ayabusa/TI-92-Brainwasher/pcb/README.md

# Custom TI-92 Module PCB
This section of the repo contains the schematic and PCB for the two different boards. You can use the `.zip` files in the gerber directory to order them on different websites.

## Ordering from PCBWay
If you want to support me you can order the PCB directly from PCBWay using these links

### Brainswap module
<a href="https://www.pcbway.com/project/shareproject/TI92_Brainswap_5000_34cc17e4.html">PCB from PCBWay</a>

### Brainwasher board
<a href="https://www.pcbway.com/project/shareproject/W1168534AS5D1_TI92_hat_a221fa38.html">PCB from PCBWay</a>

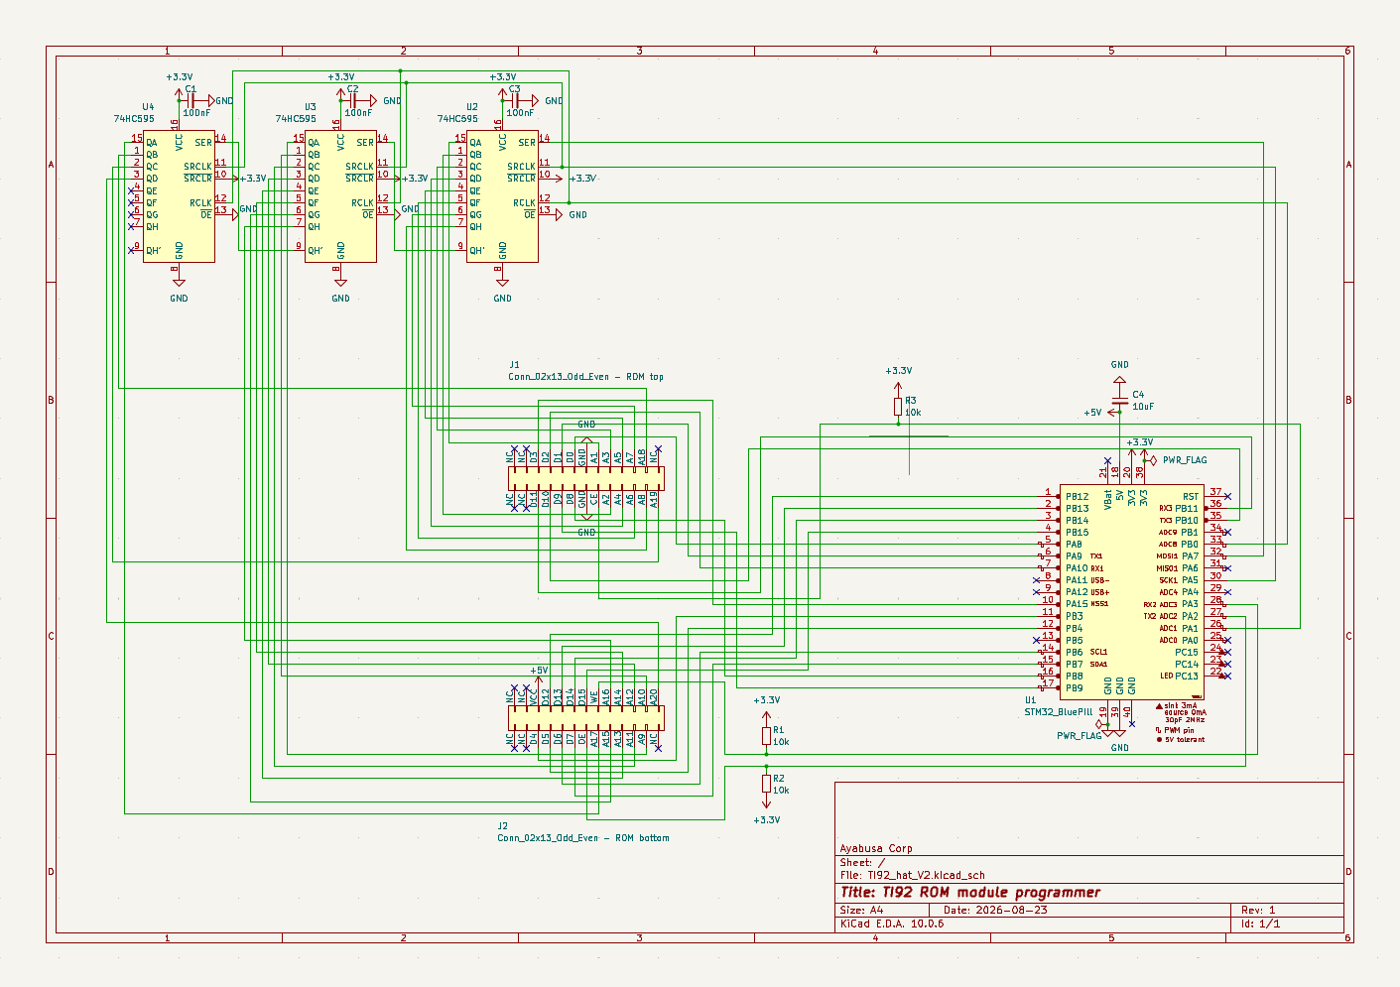
[picture p6: pcb/schema.png]
schematic

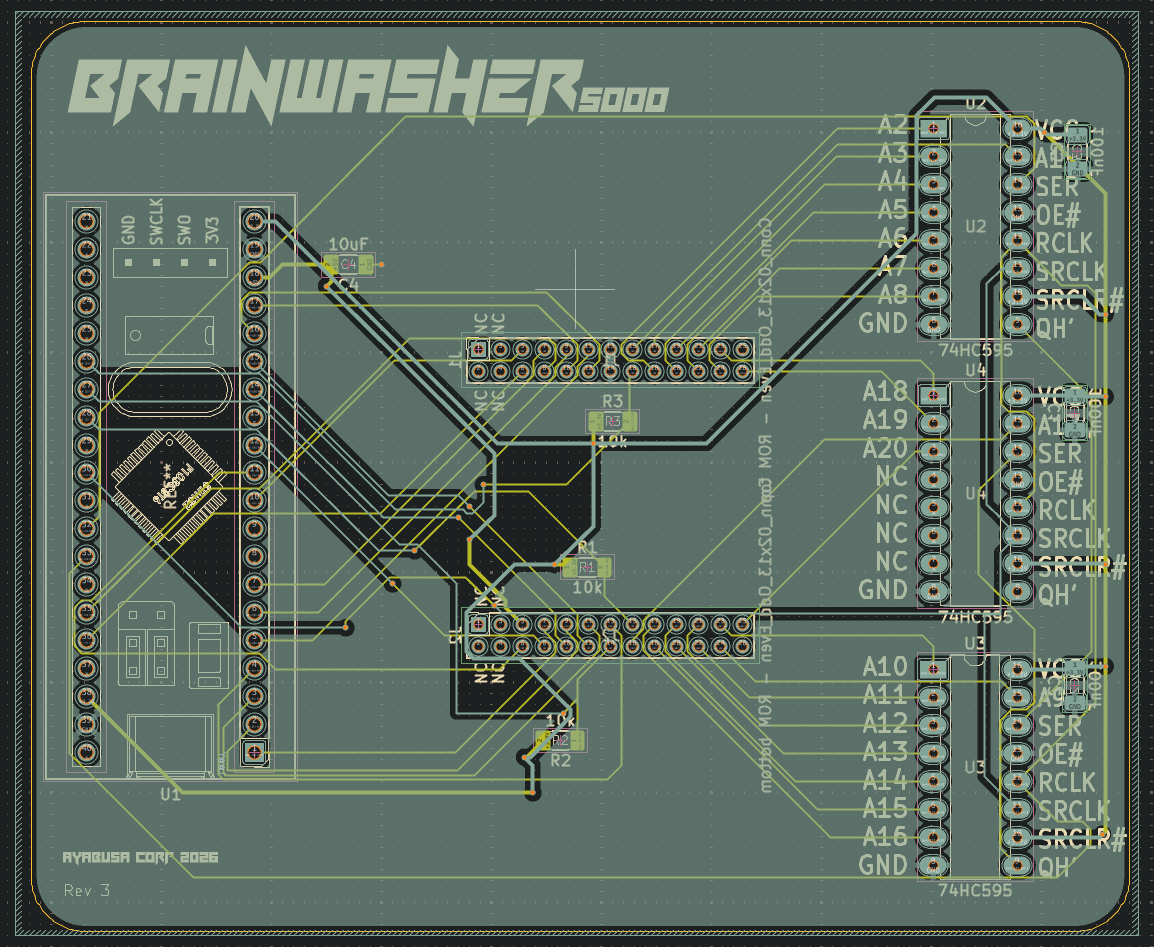
[picture p7: pcb/pcb.png]
pcb


## How to edit
These files were created using KiCad 10.0, you can edit them using this software.

## License
This part of the repo is licensed under the CC BY-NC-SA 4.0 license, see more details in the LICENSE.txt file
