ayabusa/TI-92-Brainwasher/box/box.pdf

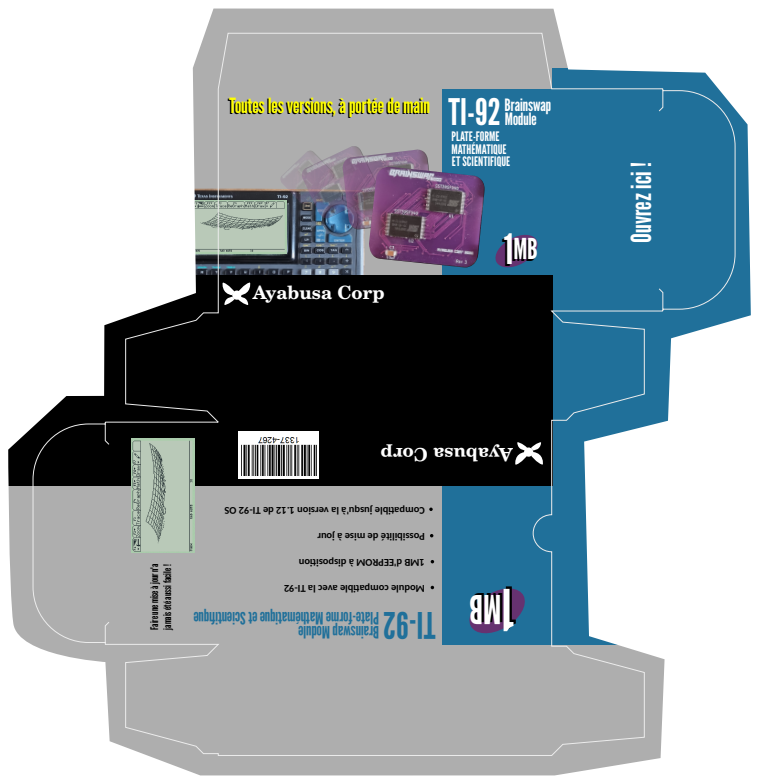
[picture p9: page 1]
TI-92 Toutes les versions, à portée de main Toutes les versions, à portée de main; Brainswap; Ouvrez ici !

Module PLATE-FORME MATHÉMATIQUE ET SCIENTIFIQUE 1MB

Ayabusa Corp

Faire une mise à jour n'a

jamais été aussi facile !
