ayabusa/TI-92-Brainwasher/pcb/TI92_module_V2/TI92_module_V2.kicad_pcb

## KiCad design pcb/TI92_module_V2/TI92_module_V2.kicad_pcb (2026-09-13)

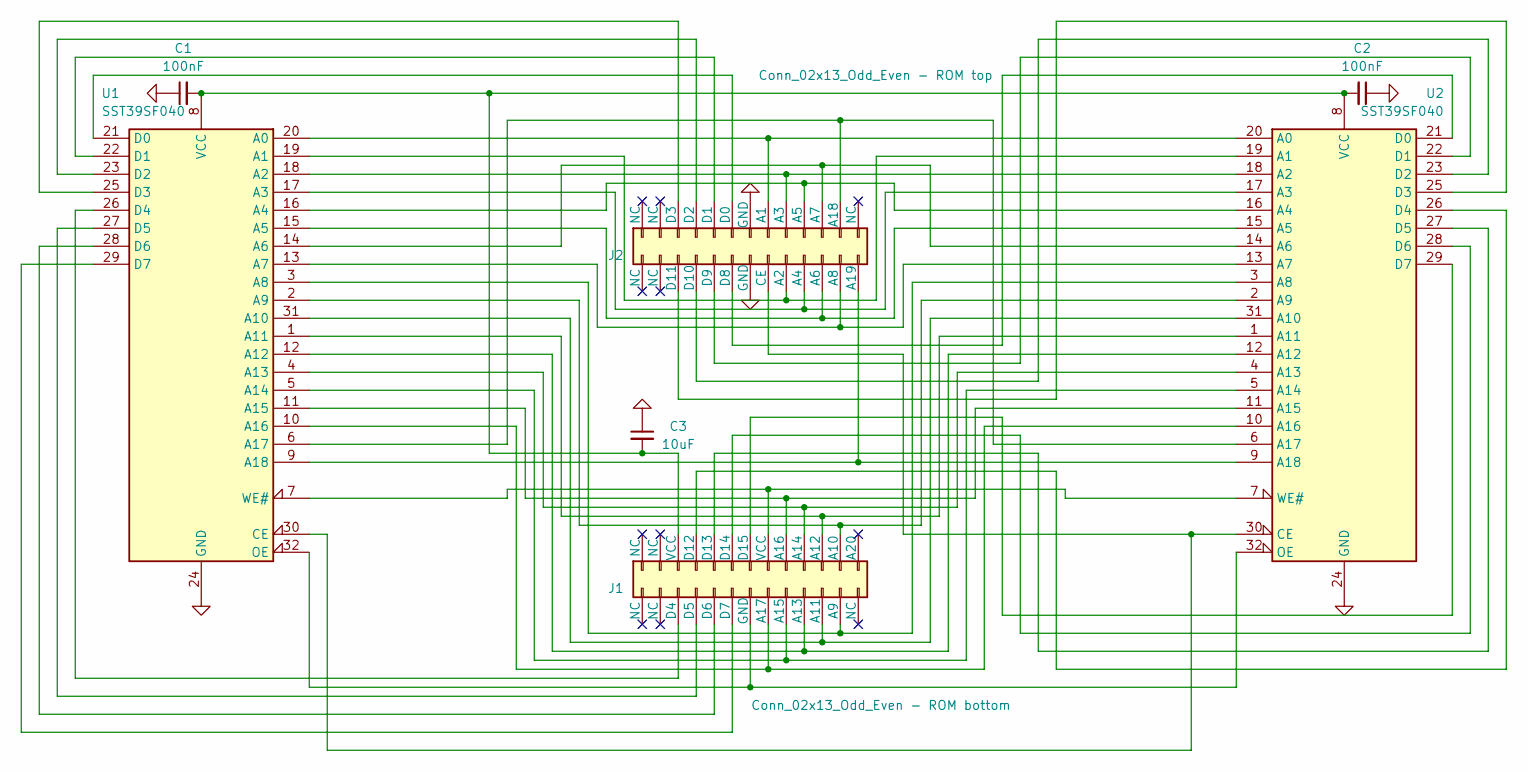
[picture p10: schematic TI92_module_V2.kicad_sch, TI-92 Custom module V2]

Parts:
C1, C2: 100nF; C_1206_3216Metric_Pad1.33x1.80mm_HandSolder
C3: 10uF; C_1206_3216Metric_Pad1.33x1.80mm_HandSolder
J1: Conn_02x13_Odd_Even - ROM bottom; PinSocket_2x13_P2.00mm_Vertical_SMD
J2: Conn_02x13_Odd_Even - ROM top; PinSocket_2x13_P2.00mm_Vertical_SMD
U1, U2: SST39SF040; SOP50P1400X120-32N

Connections:
GND: C1.1, C2.1, C3.1, J2.13 (GND), J2.14 (GND), U1.24 (GND), U2.24 (GND)
unnamed: J1.24 (A9), U1.3 (A8), U2.3 (A8)
unnamed: J1.23 (A10), U1.2 (A9), U2.2 (A9)
unnamed: J1.22 (A11), U1.31 (A10), U2.31 (A10)
unnamed: J1.21 (A12), U1.1 (A11), U2.1 (A11)
unnamed: J1.20 (A13), U1.12 (A12), U2.12 (A12)
unnamed: J1.19 (A14), U1.4 (A13), U2.4 (A13)
unnamed: J1.18 (A15), U1.5 (A14), U2.5 (A14)
unnamed: J1.17 (A16), U1.11 (A15), U2.11 (A15)
unnamed: J1.16 (A17), U1.10 (A16), U2.10 (A16)
unnamed: J1.6 (D4), U1.26 (D4)
unnamed: J1.8 (D5), U1.27 (D5)
unnamed: J1.10 (D6), U1.28 (D6)
unnamed: J1.12 (D7), U1.29 (D7)
unnamed: J1.7 (D12), U2.26 (D4)
unnamed: J1.9 (D13), U2.27 (D5)
unnamed: J1.11 (D14), U2.28 (D6)
unnamed: J1.13 (D15), U2.29 (D7)
unnamed: J1.14 (GND), U1.32 (OE), U2.32 (OE)
unnamed: J2.15 (A1), U1.20 (A0), U2.20 (A0)
unnamed: J2.18 (A2), U1.19 (A1), U2.19 (A1)
unnamed: J2.17 (A3), U1.18 (A2), U2.18 (A2)
unnamed: J2.20 (A4), U1.17 (A3), U2.17 (A3)
unnamed: J2.19 (A5), U1.16 (A4), U2.16 (A4)
unnamed: J2.22 (A6), U1.15 (A5), U2.15 (A5)
unnamed: J2.21 (A7), U1.14 (A6), U2.14 (A6)
unnamed: J2.24 (A8), U1.13 (A7), U2.13 (A7)
unnamed: J2.23 (A18), U1.6 (A17), U2.6 (A17)
unnamed: J2.26 (A19), U1.9 (A18), U2.9 (A18)
unnamed: J2.16 (CE), U1.30 (CE), U2.30 (CE)
unnamed: J2.11 (D0), U1.21 (D0)
unnamed: J2.9 (D1), U1.22 (D1)
unnamed: J2.7 (D2), U1.23 (D2)
unnamed: J2.5 (D3), U1.25 (D3)
unnamed: J2.12 (D8), U2.21 (D0)
unnamed: J2.10 (D9), U2.22 (D1)
unnamed: J2.8 (D10), U2.23 (D2)
unnamed: J2.6 (D11), U2.25 (D3)
unnamed: C1.2, C2.2, C3.2, J1.5 (VCC), U1.8 (VCC), U2.8 (VCC)
unnamed: J1.15 (VCC), U1.7 (WE#), U2.7 (WE#)

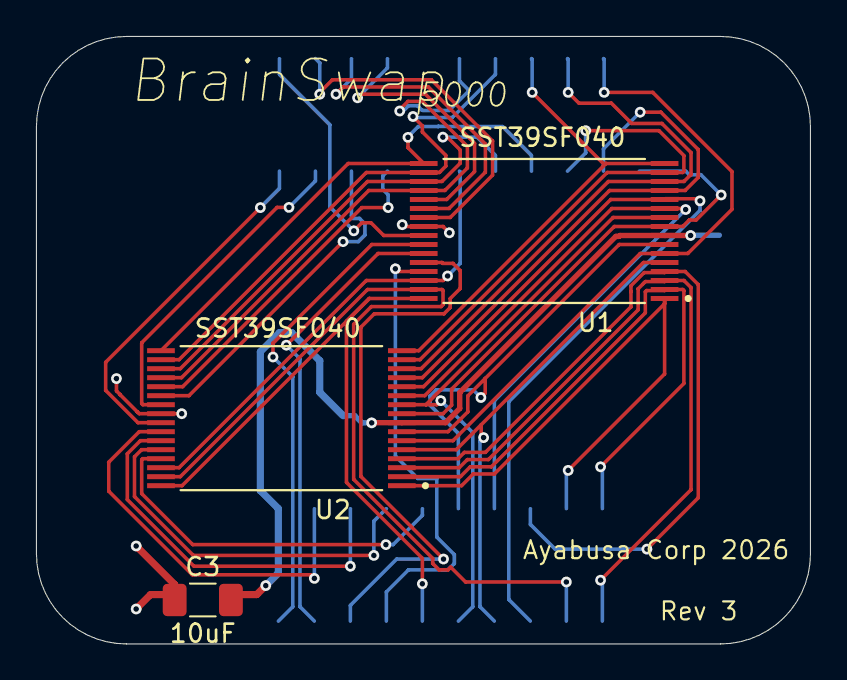
[picture p11: board TI92_module_V2.kicad_pcb from above]

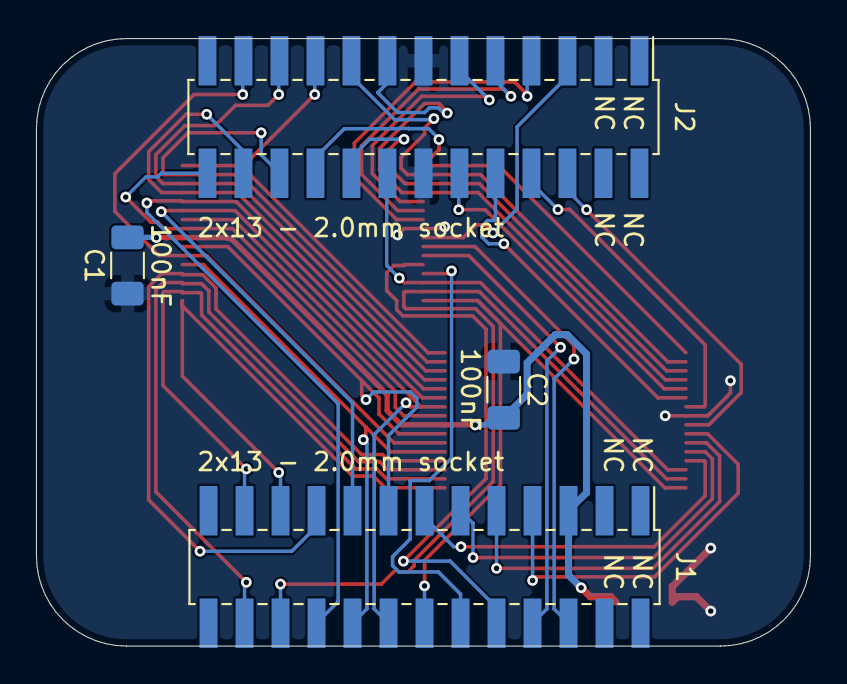
[picture p12: board TI92_module_V2.kicad_pcb from below]

Board: 2 copper layers, 43.0 x 33.8 mm, 7 parts (4 on the bottom side), 40 nets.
