ayabusa/TI-92-Brainwasher/pcb/TI92_hat_V2/TI92_hat_V2.kicad_pcb

## KiCad design pcb/TI92_hat_V2/TI92_hat_V2.kicad_pcb (2026-09-13)

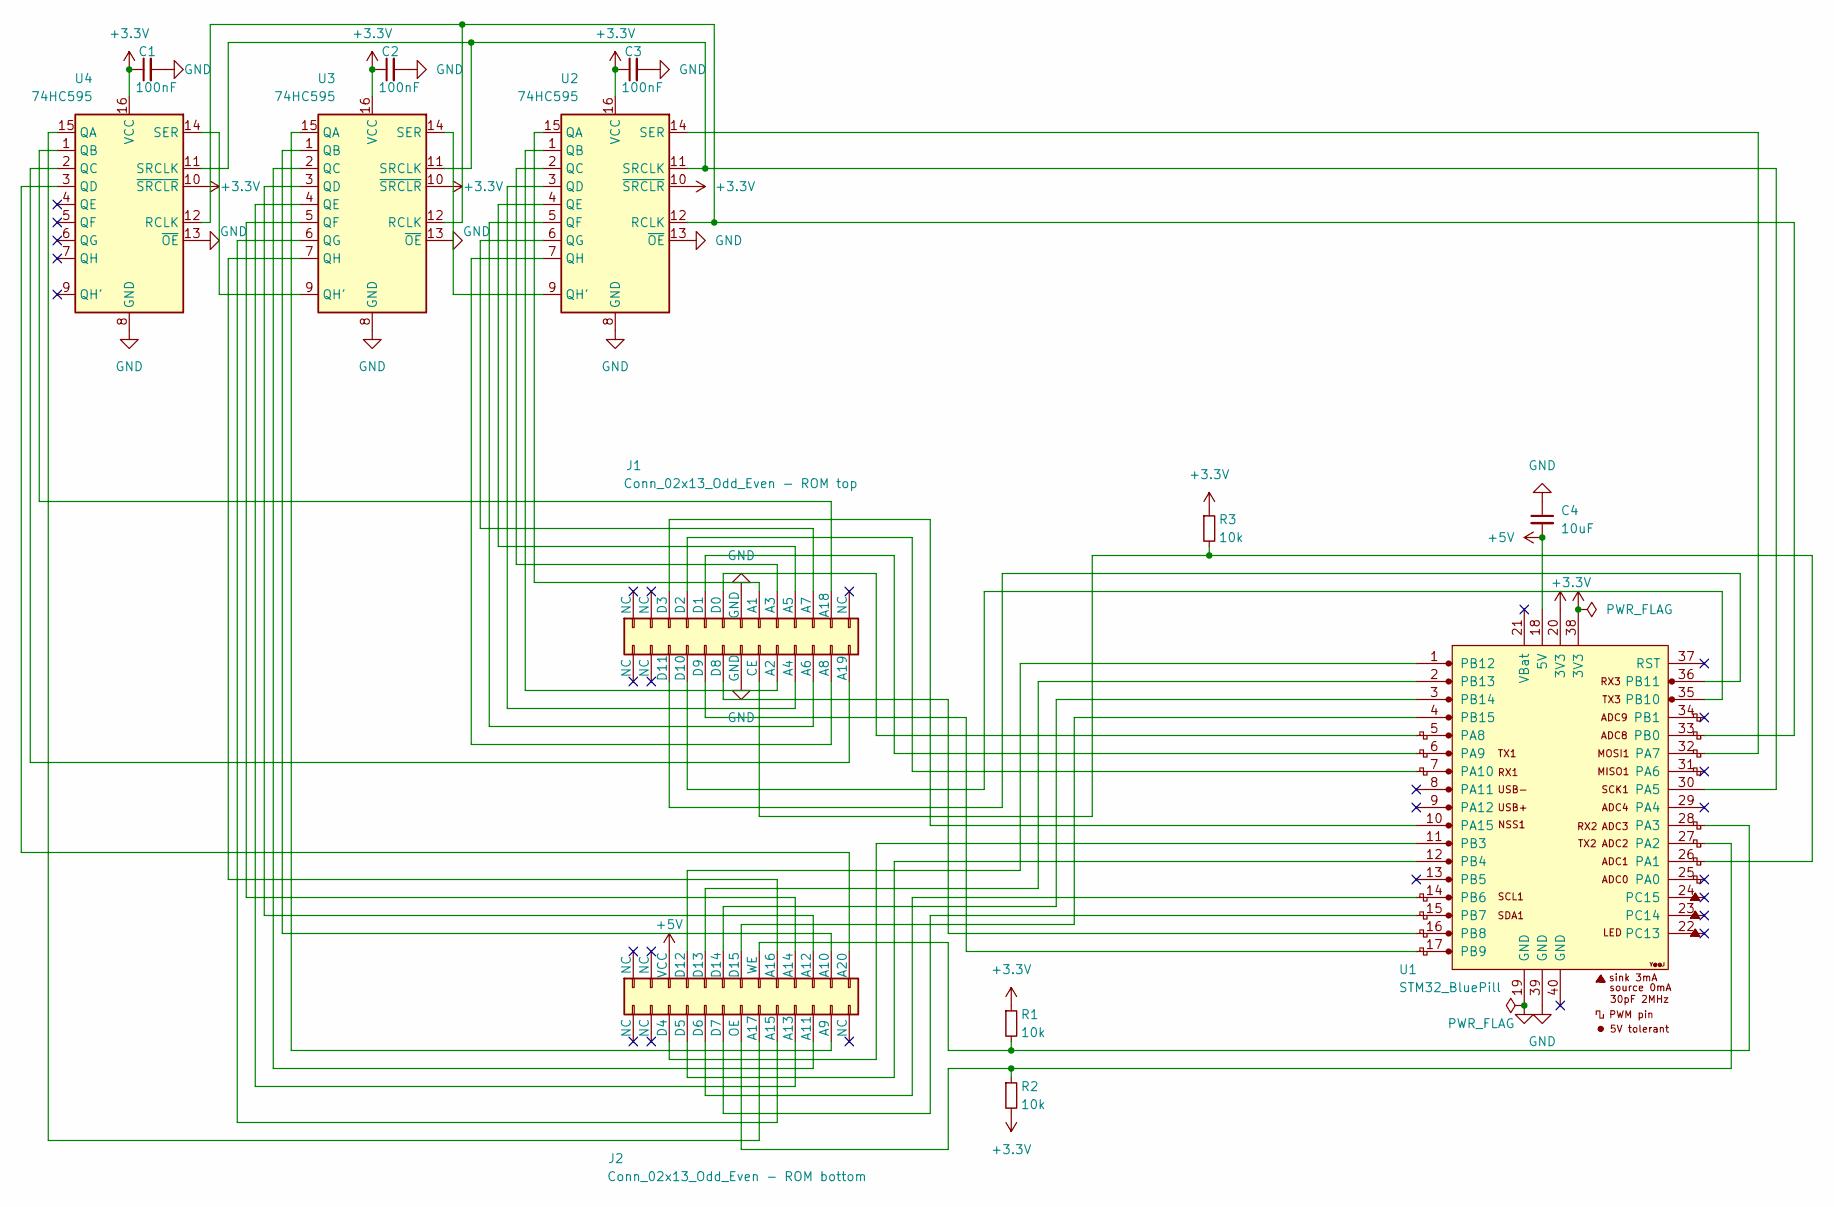
[picture p13: schematic TI92_hat_V2.kicad_sch, TI92 ROM module programmer]

Parts:
C1, C2, C3: 100nF; C_1206_3216Metric_Pad1.33x1.80mm_HandSolder
C4: 10uF; C_1206_3216Metric_Pad1.33x1.80mm_HandSolder
J1: Conn_02x13_Odd_Even - ROM top; PinHeader_2x13_P2.00mm_Vertical
J2: Conn_02x13_Odd_Even - ROM bottom; PinHeader_2x13_P2.00mm_Vertical
R1, R2, R3: 10k; R_1206_3216Metric_Pad1.30x1.75mm_HandSolder
U1: STM32_BluePill; YAAJ_BluePill_1
U2, U3, U4: 74HC595; DIP-16_W7.62mm_LongPads

Connections:
+3.3V: C1.1, C2.1, C3.1, R1.1, R2.2, R3.1, U1.20 (3V3), U1.38 (3V3), U2.10 (~SRCLR), U2.16 (VCC), U3.10 (~SRCLR), U3.16 (VCC), U4.10 (~SRCLR), U4.16 (VCC)
+5V: C4.2, J2.5 (VCC), U1.18 (5V)
GND: C1.2, C2.2, C3.2, C4.1, J1.13 (GND), J1.14 (GND), U1.19 (GND), U1.39 (GND), U2.8 (GND), U2.13 (~OE), U3.8 (GND), U3.13 (~OE), U4.8 (GND), U4.13 (~OE)
unnamed: J1.15 (A1), U2.15 (QA)
unnamed: J1.18 (A2), U2.1 (QB)
unnamed: J1.17 (A3), U2.2 (QC)
unnamed: J1.20 (A4), U2.3 (QD)
unnamed: J1.19 (A5), U2.4 (QE)
unnamed: J1.22 (A6), U2.5 (QF)
unnamed: J1.21 (A7), U2.6 (QG)
unnamed: J1.24 (A8), U2.7 (QH)
unnamed: J1.23 (A18), U4.1 (QB)
unnamed: J1.26 (A19), U4.2 (QC)
unnamed: J1.16 (CE), R3.2, U1.26 (PA1)
unnamed: J1.11 (D0), U1.5 (PA8)
unnamed: J1.9 (D1), U1.6 (PA9)
unnamed: J1.7 (D2), U1.7 (PA10)
unnamed: J1.5 (D3), U1.10 (PA15)
unnamed: J1.12 (D8), U1.16 (PB8)
unnamed: J1.10 (D9), U1.17 (PB9)
unnamed: J1.8 (D10), U1.35 (PB10)
unnamed: J1.6 (D11), U1.36 (PB11)
unnamed: J2.24 (A9), U3.15 (QA)
unnamed: J2.23 (A10), U3.1 (QB)
unnamed: J2.22 (A11), U3.2 (QC)
unnamed: J2.21 (A12), U3.3 (QD)
unnamed: J2.20 (A13), U3.4 (QE)
unnamed: J2.19 (A14), U3.5 (QF)
unnamed: J2.18 (A15), U3.6 (QG)
unnamed: J2.17 (A16), U3.7 (QH)
unnamed: J2.16 (A17), U4.15 (QA)
unnamed: J2.25 (A20), U4.3 (QD)
unnamed: J2.6 (D4), U1.11 (PB3)
unnamed: J2.8 (D5), U1.12 (PB4)
unnamed: J2.10 (D6), U1.14 (PB6)
unnamed: J2.12 (D7), U1.15 (PB7)
unnamed: J2.7 (D12), U1.1 (PB12)
unnamed: J2.9 (D13), U1.2 (PB13)
unnamed: J2.11 (D14), U1.3 (PB14)
unnamed: J2.13 (D15), U1.4 (PB15)
unnamed: J2.14 (OE), R2.1, U1.27 (PA2)
unnamed: J2.15 (WE), R1.2, U1.28 (PA3)
unnamed: U1.30 (PA5), U2.11 (SRCLK), U3.11 (SRCLK), U4.11 (SRCLK)
unnamed: U1.32 (PA7), U2.14 (SER)
unnamed: U1.33 (PB0), U2.12 (RCLK), U3.12 (RCLK), U4.12 (RCLK)
unnamed: U2.9 (QH'), U3.14 (SER)
unnamed: U3.9 (QH'), U4.14 (SER)

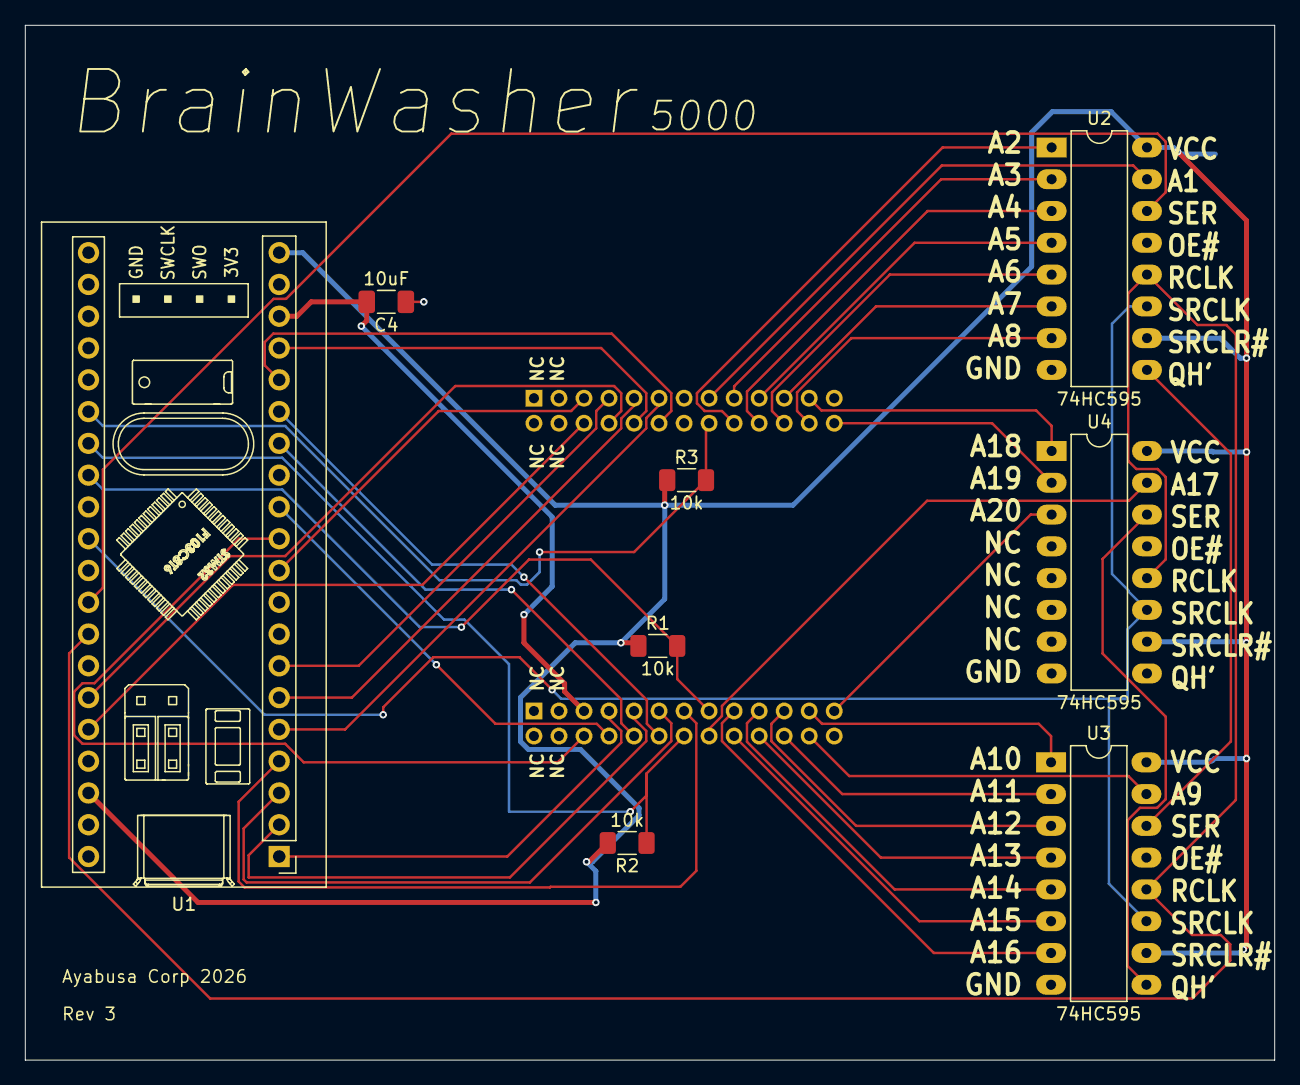
[picture p14: board TI92_hat_V2.kicad_pcb from above]

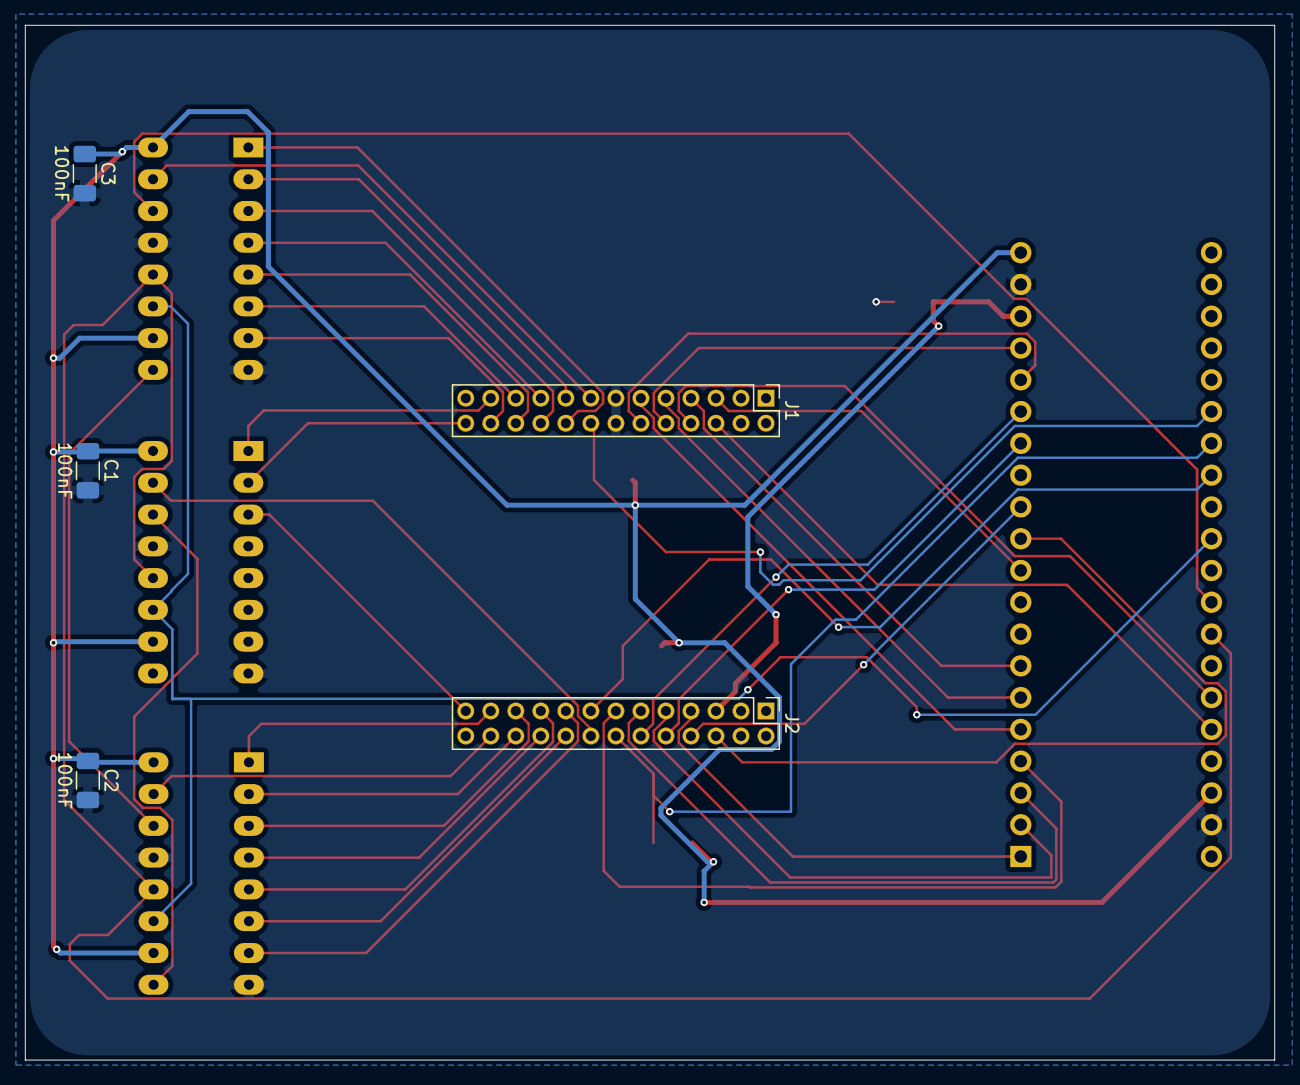
[picture p15: board TI92_hat_V2.kicad_pcb from below]

Board: 2 copper layers, 99.8 x 82.7 mm, 13 parts (5 on the bottom side), 47 nets.
