ayabusa/TI-92-Brainwasher/firmware/Core/Inc/main.h

#define USER_KEY_Pin GPIO_PIN_0
#define USER_KEY_GPIO_Port GPIOA
#define FLASH_CS_Pin GPIO_PIN_4
#define FLASH_CS_GPIO_Port GPIOA
#define LED_BLUE_Pin GPIO_PIN_2
#define LED_BLUE_GPIO_Port GPIOB
#define ADDR_RCLK_PORT  GPIOB
#define ADDR_RCLK_PIN   GPIO_PIN_0
#define ADDR_SRCLK_PORT GPIOA
#define ADDR_SRCLK_PIN  GPIO_PIN_5
#define ADDR_SER_PORT   GPIOA
#define ADDR_SER_PIN    GPIO_PIN_7
#define CP_PORT GPIOA
#define CP_CE_PIN  GPIO_PIN_1
#define CP_OE_PIN  GPIO_PIN_2
#define CP_WE_PIN  GPIO_PIN_3
