ayabusa/TI-92-Brainwasher/(commit log)

2026-09-13 Initial public commit
    [TI92_hat_V2-B_Cu.gbr, TI92_hat_V2-B_Mask.gbr, TI92_hat_V2-B_Paste.gbr, TI92_hat_V2-B_Silkscreen.gbr, TI92_hat_V2-Edge_Cuts.gbr, TI92_hat_V2-F_Cu.gbr, TI92_hat_V2-F_Mask.gbr, TI92_hat_V2-F_Paste.gbr]
2026-11-01 Update pcb readme
